nuljon/DIYspotWelder4/DIYspotwelder4.pdf

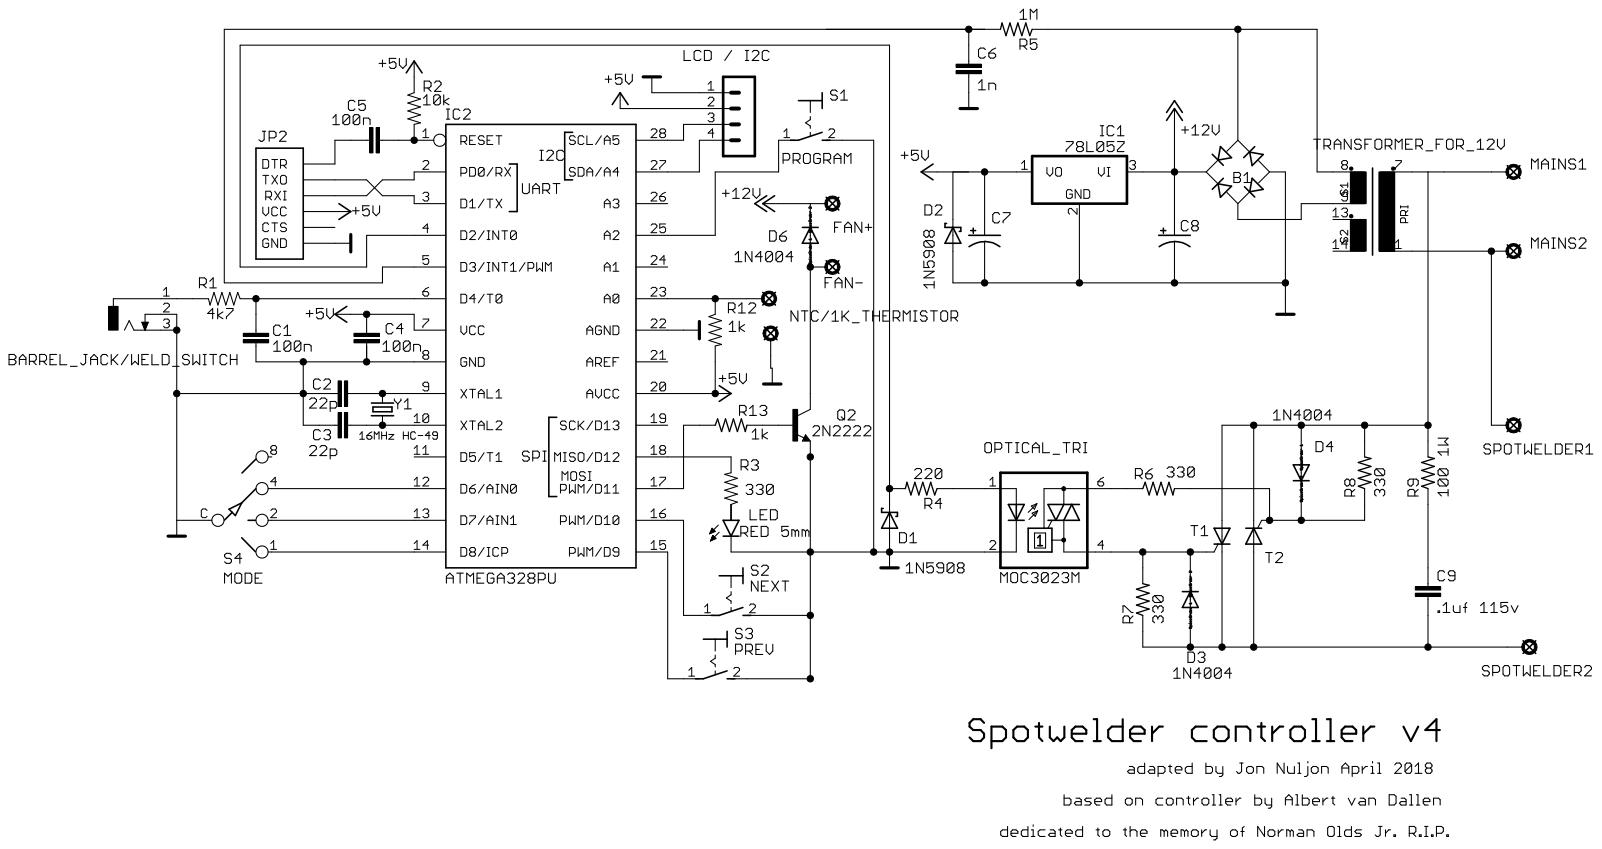
[picture p2: page 1]
