nuljon/DIYspotWelder4/(commit log)

2018-01-17 added link to circuit schematic DIYspotwelder.pdf
2018-01-17 added thermal cutoff protection and fixed bug in useDefaultConfig
    [DIYspotwelder4.ino, ThermalControl.cpp, ThermalControl.h, WeldPattern.cpp, WeldPattern.h]
2018-01-20 add front panel programming feature to change thermal control settings and weld pulse timings.
2018-03-31 reworked set methods to squash bugs - passes preliminary hardware test
    [DIYspotwelder4.ino, ThermalControl.cpp, ThermalControl.h, WeldPattern.cpp, WeldPattern.h]
2018-03-31 uploading circuit schematic as png
2018-03-31 Updated readme to include graphic of circuit
2018-04-07 Fixed bug reading temperature in circuit and code. updated schematics
    [ThermalControl.cpp, WeldPattern.cpp]
2018-05-08 fixed bugs passing welderControlPin reference and displaying fanSpeed
    [DIYspotwelder4.ino, ThermalControl.cpp, ThermalControl.h, WeldPattern.cpp, WeldPattern.h]
